danielh121220-cmd/N.A.V.I./docs/CONFIGURACION_WHATSAPP_Y_EMAIL.md

# Avisos a representantes: correo, SMS, WhatsApp y Telegram

Por defecto N.A.V.I avisa solo cuando hay **atraso** o **ausencia** (se cambia en **Ajustes → Avisos a representantes**). Todo se configura desde la app, en **Ajustes → Canales**, sin tocar archivos.

| Canal | Cómo llega | Qué necesitas |
| --- | --- | --- |
| Correo | Automático, con diseño, foto del estudiante y copia al DECE | Una cuenta de Gmail con contraseña de aplicación |
| SMS | Automático, como mensaje de texto normal, aunque el celular del representante no tenga internet | Un celular Android con chip y la app N.A.V.I abierta |
| WhatsApp un toque | La app prepara el mensaje y tú tocas "Enviar" | Nada, funciona desde hoy |
| WhatsApp con Twilio | Automático. Con la cuenta gratis sale dentro de una plantilla de Twilio en inglés; con cuenta pagada, el aviso completo | Cuenta de Twilio (gratis para probar) |
| WhatsApp con Meta | Sale solo desde el número del colegio | Cuenta de Meta Business y una plantilla aprobada |
| Telegram | Automático, gratis y con el texto completo | Un bot de @BotFather (se pega en la app) |

## Correo

1. En la cuenta de Google que enviará los correos activa la **verificación en 2 pasos**.
2. Entra a https://myaccount.google.com/apppasswords, crea una contraseña llamada `NAVI` y copia las 16 letras.
3. En la app: **Ajustes → Canales → Correo**, elige **Gmail**, escribe el correo y pega la contraseña. Toca **Guardar**: N.A.V.I comprueba la conexión al instante y te dice si algo está mal.
4. En **Probar** escribe tu correo y toca **Probar**. Te llega un aviso de ejemplo igual al que verá el representante.

Si el colegio tiene correo propio (`@colegio.edu.ec`), elige **Otro** y pon el servidor SMTP y el puerto que te dé el técnico. Outlook también funciona, pero Microsoft a veces bloquea el envío desde programas: si falla, usa Gmail.

### Copia a la institución

En la misma pantalla, en **Institución**:

- **Correo DECE**: inspección, DECE o el tutor. Puedes poner varios separados por coma.
- **Con copia**: *Ausencias y emergencias* (recomendado), *Todos los avisos* o *Nunca*.
- **Teléfono**: aparece en los avisos urgentes para que el representante llame.
- **Firma**: por ejemplo *Inspección General*.

Cuando un representante responde un correo, la respuesta llega al correo del DECE, no a la cuenta que envía.

### Varios correos por estudiante

En la ficha del estudiante, el campo **Correo** acepta dos correos separados por coma (por ejemplo el del papá y el de la mamá). Los dos reciben el aviso.

## SMS (mensaje de texto al número del representante)

Los SMS salen de un **celular Android con chip** que tenga la app N.A.V.I abierta: puede ser el del docente o uno del colegio. Cada SMS usa el saldo o el plan de ese chip.

1. En la PC: **Ajustes → Canales → SMS al celular** y activa **Enviar avisos por SMS** (solo el administrador).
2. En el celular que enviará los SMS: abre la app de Android, entra con tu cuenta y ve a **Ajustes → SMS al celular**. Activa **Enviar los SMS desde este celular** y acepta el permiso de SMS.
3. En **Probar**, escribe tu número y toca **Probar**: te llega un SMS de ejemplo.
4. En **Ajustes → Avisos a representantes** elige qué avisar: atrasos, ausencias o **cada llegada**.

El mensaje dice, por ejemplo: *«N.A.V.I · Colegio: Daniel Heredia ingresó a clases a las 07:02.»*

- Si el celular que envía está apagado o sin internet, los SMS quedan **esperando** y salen solos apenas vuelve (hasta 6 horas después).
- En **Inicio → Avisos** cada SMS aparece como *Esperando celular*, *Enviando*, *Enviado* o *Falló* (con el motivo: sin señal, sin saldo, modo avión).
- Deja la app abierta o en segundo plano. Si Android la cierra para ahorrar batería, en los ajustes del celular quita la optimización de batería para N.A.V.I.
- En la versión de demostración los SMS no se envían, para no escribir a números inventados.

## WhatsApp

### Un toque (sin configurar nada)

Cada aviso aparece en **Inicio → Avisos** con un botón verde **Enviar**. Al tocarlo se abre WhatsApp con el mensaje ya escrito; solo presionas enviar y vuelves. Si hay varios, toca **N por enviar** arriba de la lista para mandarlos uno tras otro. Cada uno queda marcado como enviado.

Con **También en lo urgente** activado, las ausencias y emergencias se preparan por WhatsApp aunque el correo haya llegado, porque es lo que más leen los padres.

El celular se puede escribir como `0991234567`, `991234567` o `+593 99 123 4567`. Si está mal escrito, la app no te deja guardarlo.

### Automático con Twilio

1. Crea una cuenta gratis en https://www.twilio.com/try-twilio y copia el **Account SID** y el **Auth Token** de la consola.
2. En **Try it out → Send a WhatsApp message** elige el celular que recibirá los avisos y, desde ese WhatsApp, envía `join twilio-trial` al **+1 737 250 8034**.
3. En **Ajustes → Canales → WhatsApp** elige **Twilio**, pega el SID y el token, deja **Plantilla** vacía y toca **Probar**.

Con la cuenta gratis, Twilio no deja mandar texto propio: N.A.V.I lo detecta sola y envía el aviso dentro de la plantilla gratuita de Twilio, por ejemplo *Reminder: Appt N.A.V.I: Daniel Heredia ingresó con atraso, 07:14…*. La cuenta gratis permite un solo celular a la vez. Con una cuenta pagada y el número del sandbox (`+14155238886`) llega el aviso completo en español, siempre que el representante haya escrito al número en las últimas 24 horas.

El Auth Token es como una contraseña: se guarda solo en la PC del servidor, nunca en GitHub, y no se comparte en capturas ni chats.

### Automático (API oficial de Meta)

WhatsApp no permite que un programa escriba solo a cualquier número sin su API oficial. Para activarla:

1. Entra a https://developers.facebook.com/apps, crea una app de tipo **Empresa** y agrega **WhatsApp**.
2. Copia el **Phone number ID** y crea un **token permanente** (usuario del sistema en Meta Business).
3. Crea una plantilla de categoría **Utilidad** llamada `navi_aviso` con este texto:
   ```
   Hola {{1}}, {{2}}
   ```
4. Cuando Meta la apruebe, en **Ajustes → Canales → WhatsApp** elige **Automático**, pega los datos, guarda y usa **Probar**.

Si el envío automático falla (token vencido, número fuera de la lista de prueba), el aviso no se pierde: queda como enlace de un toque y la app te explica el motivo.

## Mensajes escritos por el docente

En **Estudiantes → (estudiante) → Enviar mensaje al representante** puedes escribir un mensaje propio o usar una plantilla: citación a reunión, atrasos frecuentes, recordatorio o felicitación. Eliges por dónde enviarlo y ves la vista previa antes.

## Si un aviso falla

Toca el aviso en **Inicio → Avisos** para ver el mensaje completo, a quién se envió y el motivo del error en palabras simples. Los correos fallidos se pueden **reintentar** desde ahí. Si el servidor de correo no responde, N.A.V.I reintenta solo dos veces antes de marcarlo como fallido.

## Telegram

1. En Telegram habla con **@BotFather**, escribe `/newbot`, ponle un nombre (por ejemplo **N.A.V.I Avisos**) y un usuario que termine en `bot`.
2. Copia el token que te da y pégalo en **Ajustes → Canales → Telegram**. Toca **Probar**: debe decir *Conectado con @tu_bot*. No hace falta reiniciar.
3. En **Estudiantes → (estudiante) → Copiar enlace de Telegram** obtienes un enlace único para ese representante. Cuando lo abra y toque **Iniciar**, queda vinculado.

## Configuración por archivo (opcional)

Si prefieres, el correo también se puede poner en `backend/.env` con `SMTP_USER` y `SMTP_PASS`, y Telegram con `TELEGRAM_BOT_TOKEN`. Lo que configures en la app tiene prioridad.
