danielh121220-cmd/N.A.V.I./docs/reporte/img/mensaje.jpg

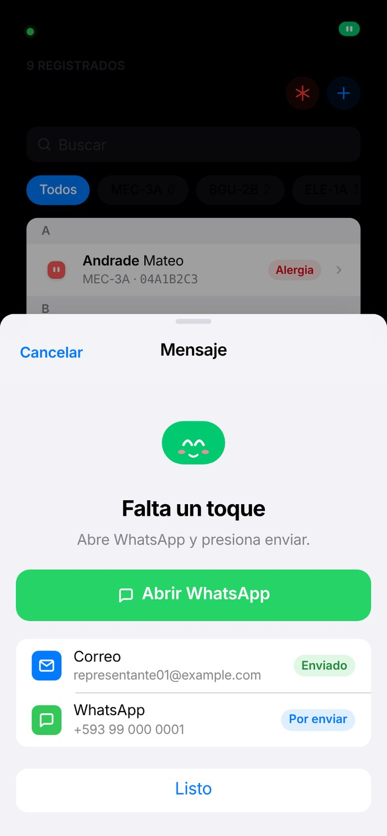
docs/reporte/img/mensaje.jpg
