danielh121220-cmd/N.A.V.I./hardware/cad/vistas/camara.png

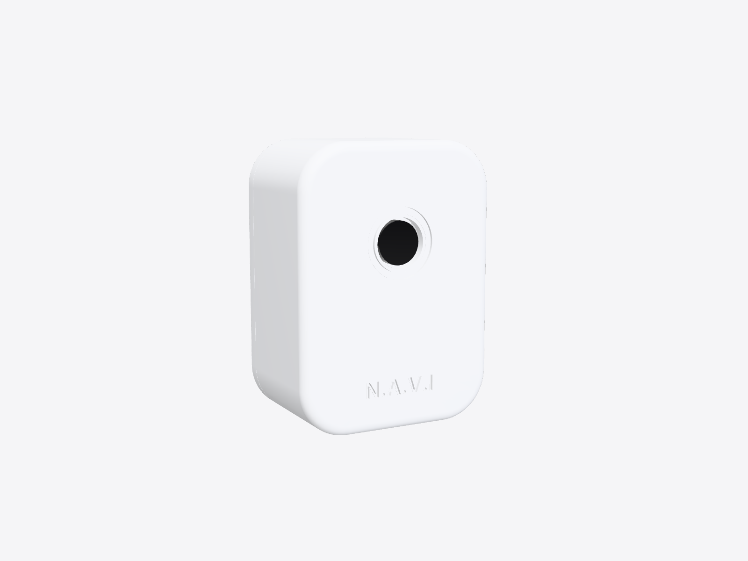
hardware/cad/vistas/camara.png
