danielh121220-cmd/N.A.V.I./hardware/cad/vistas/exhibidor.png

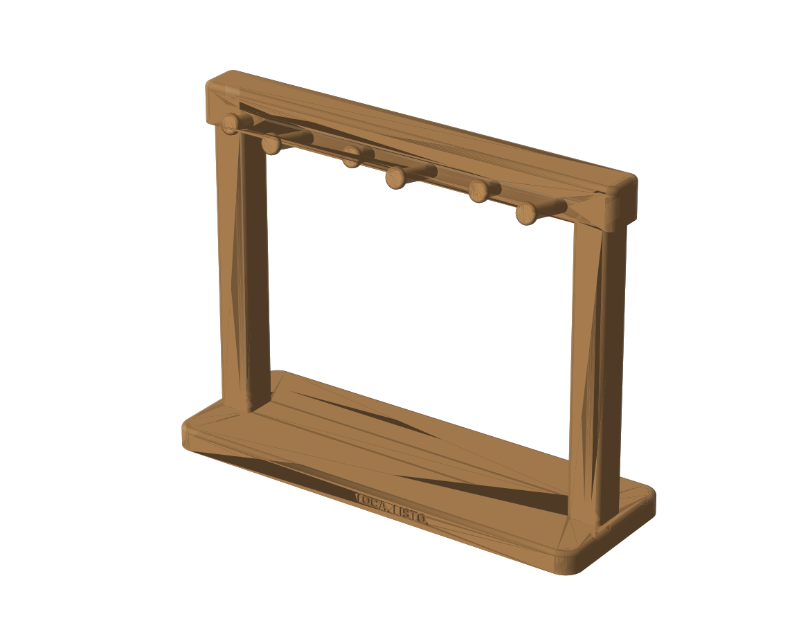
hardware/cad/vistas/exhibidor.png
