danielh121220-cmd/N.A.V.I./hardware/cad/vistas/lector_atras.png

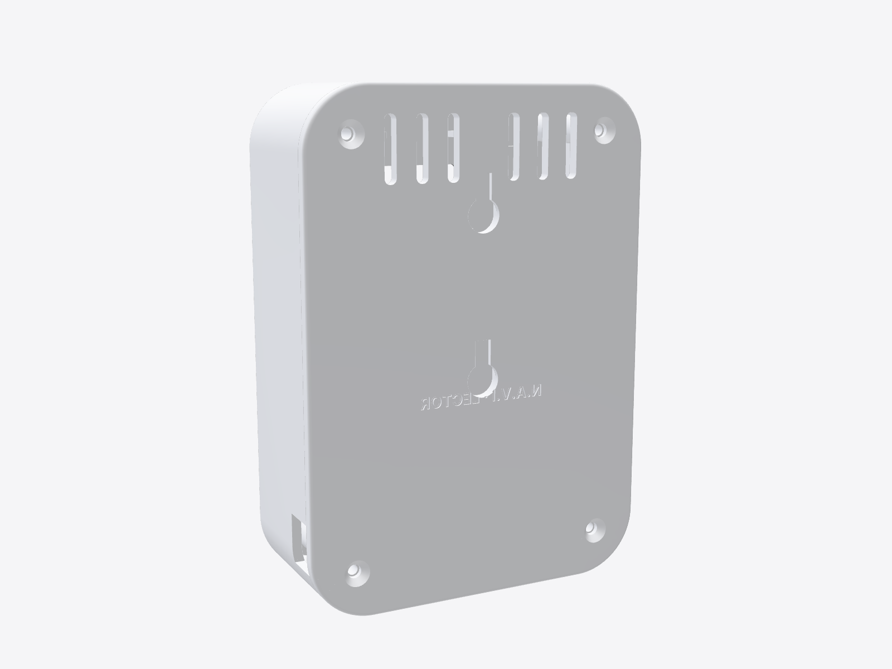
hardware/cad/vistas/lector_atras.png
