danielh121220-cmd/N.A.V.I./hardware/cad/vistas/lector_explosionado.png

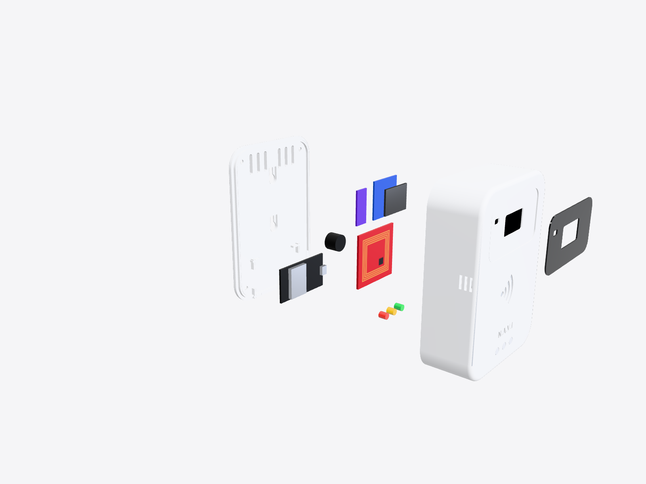
hardware/cad/vistas/lector_explosionado.png
