danielh121220-cmd/N.A.V.I./hardware/cad/vistas/lector_frente.png

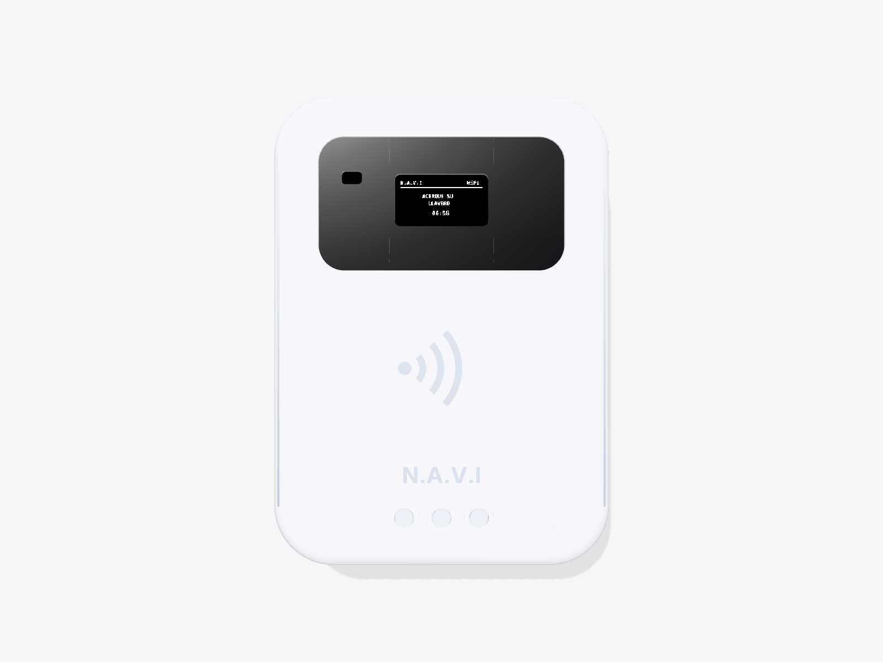
hardware/cad/vistas/lector_frente.png
