danielh121220-cmd/N.A.V.I./hardware/cad/vistas/llavero_atras.png

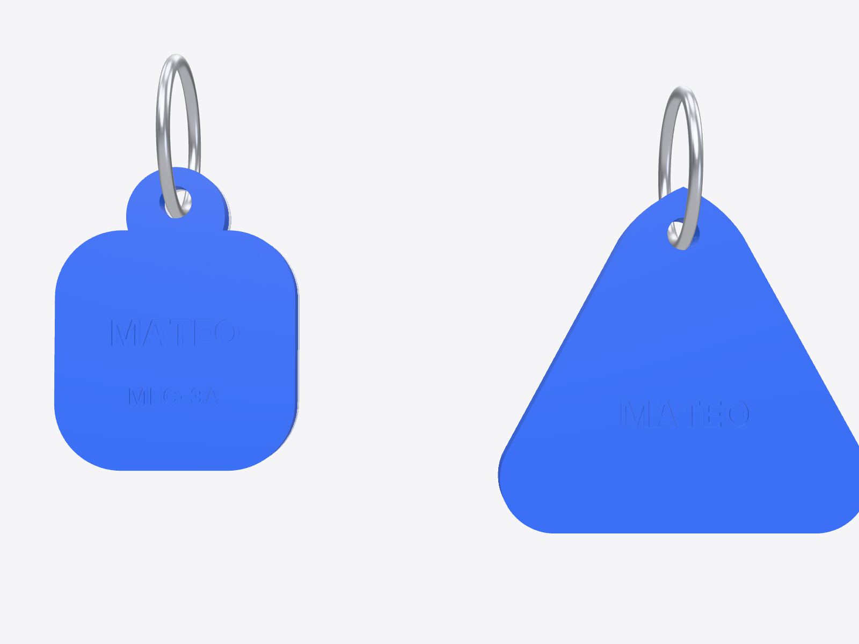
hardware/cad/vistas/llavero_atras.png
