danielh121220-cmd/N.A.V.I./hardware/cad/vistas/llavero_partes.png

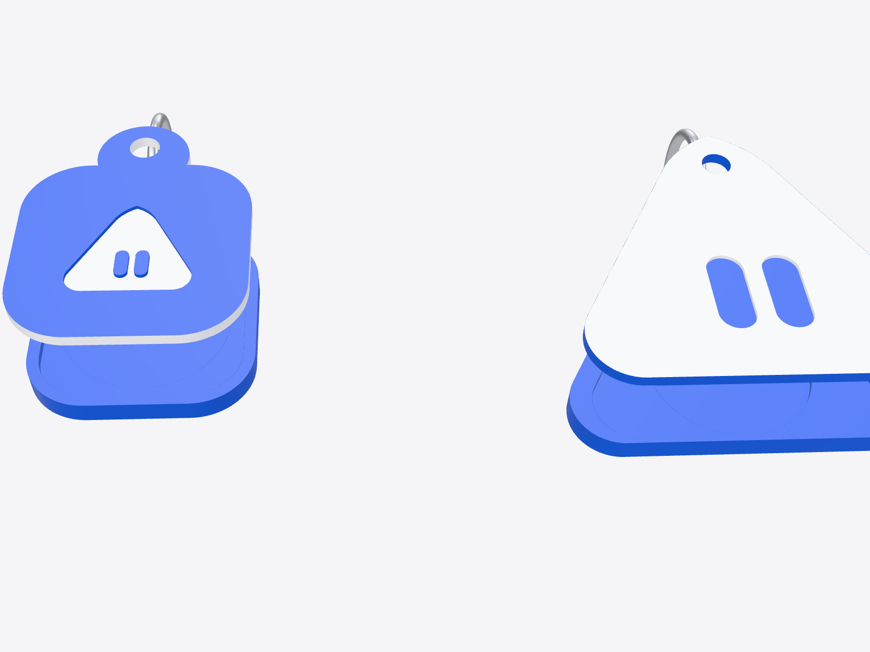
hardware/cad/vistas/llavero_partes.png
