danielh121220-cmd/N.A.V.I./tools/video/assets/desk_inicio.png

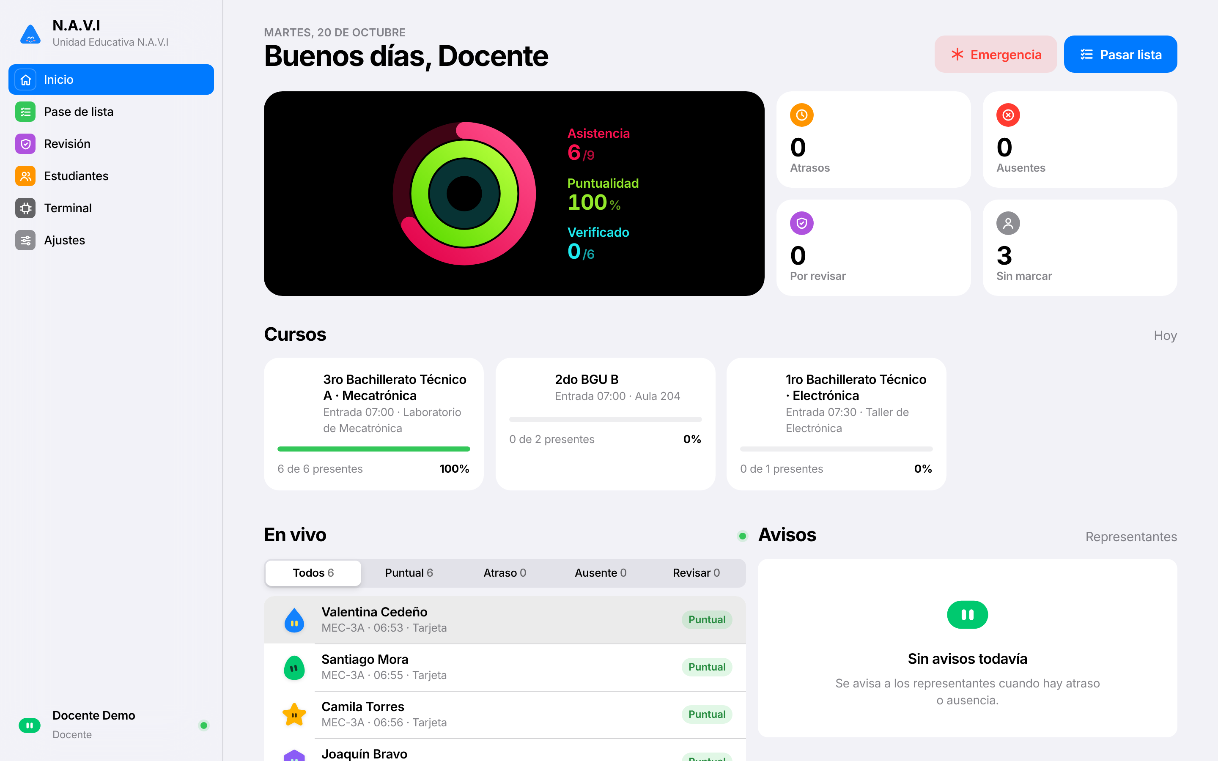
tools/video/assets/desk_inicio.png
