danielh121220-cmd/N.A.V.I./tools/video/assets/ph_born.png

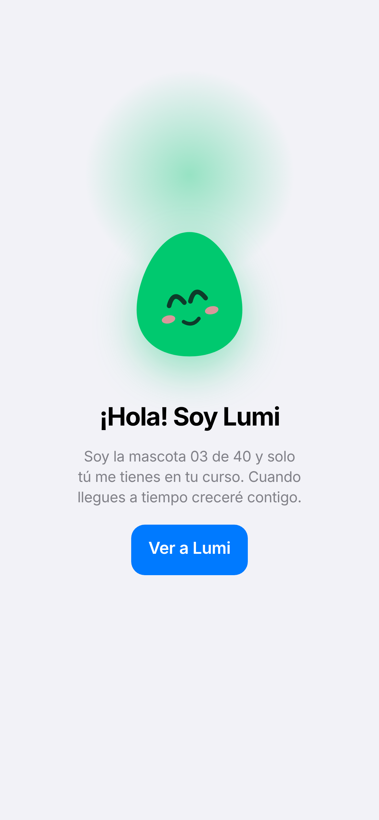
tools/video/assets/ph_born.png
