danielh121220-cmd/N.A.V.I./tools/video/assets/ph_egg.png

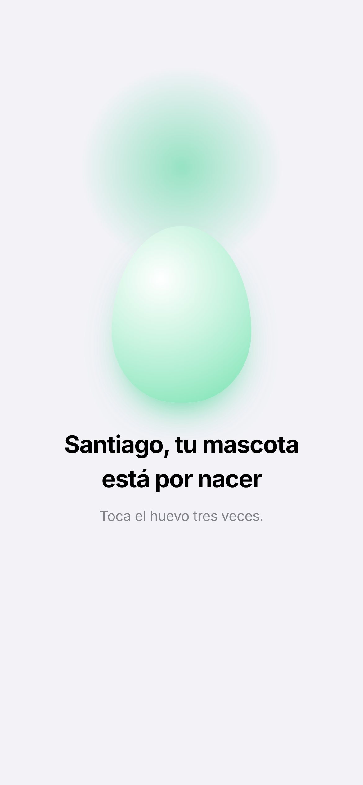
tools/video/assets/ph_egg.png
