danielh121220-cmd/N.A.V.I./tools/video/assets/ph_ficha.png

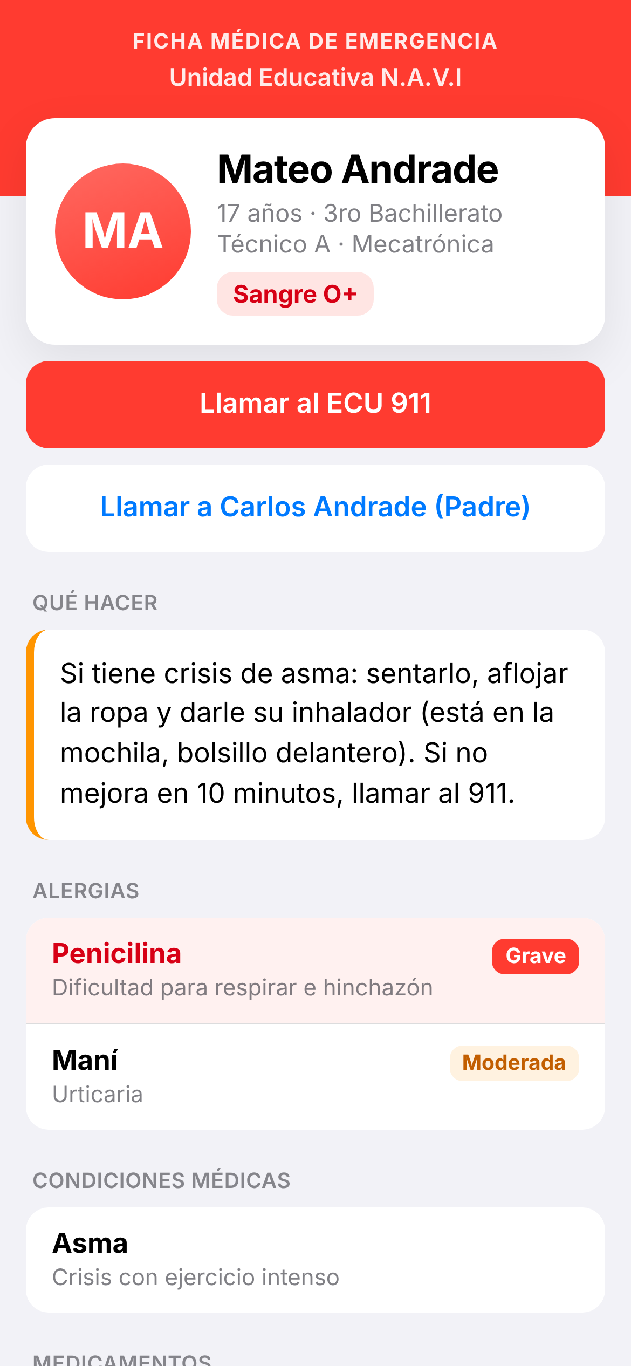
tools/video/assets/ph_ficha.png
