danielh121220-cmd/N.A.V.I./tools/video/assets/ph_gone.png

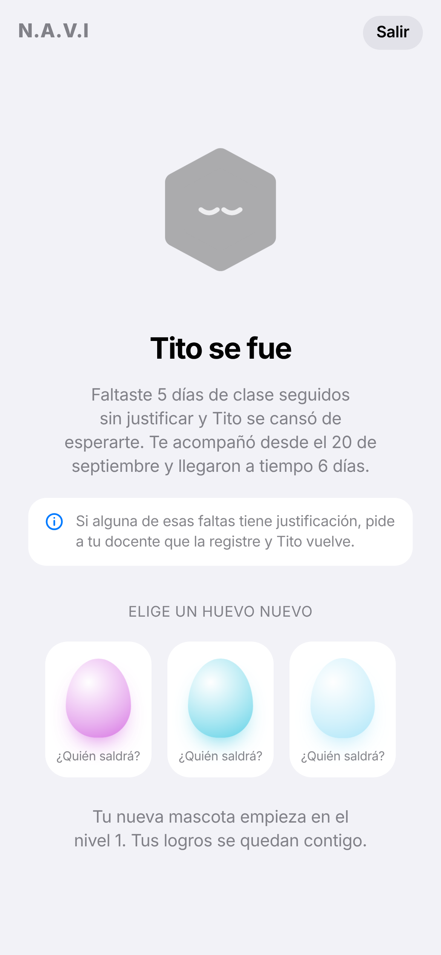
tools/video/assets/ph_gone.png
