danielh121220-cmd/N.A.V.I./tools/video/assets/ph_portal.png

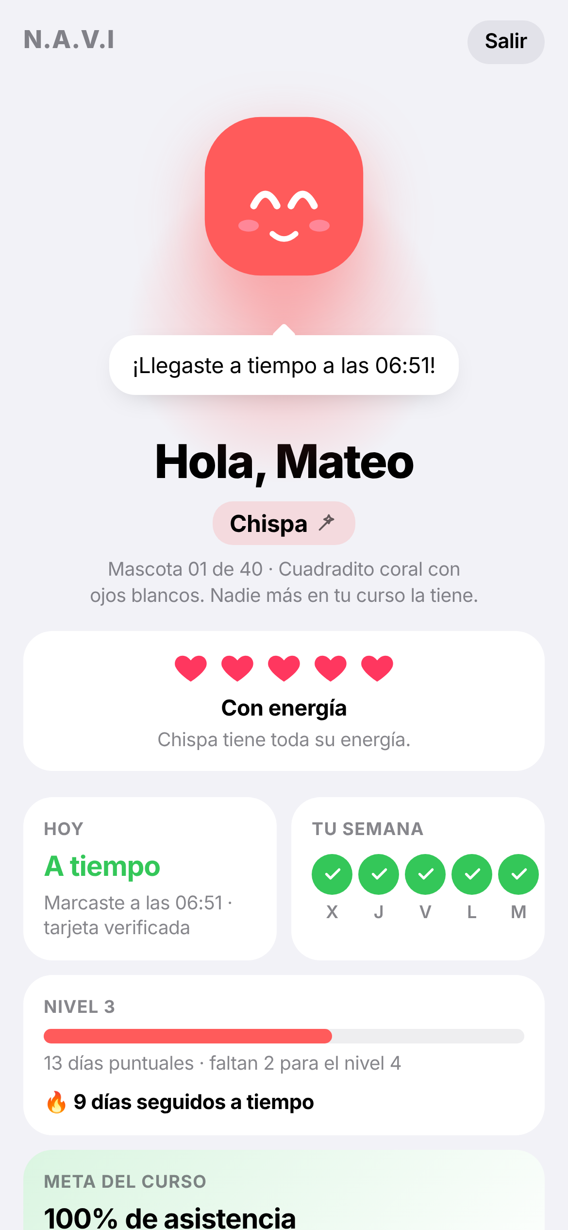
tools/video/assets/ph_portal.png
