danielh121220-cmd/N.A.V.I./tools/video/assets/ph_sick.png

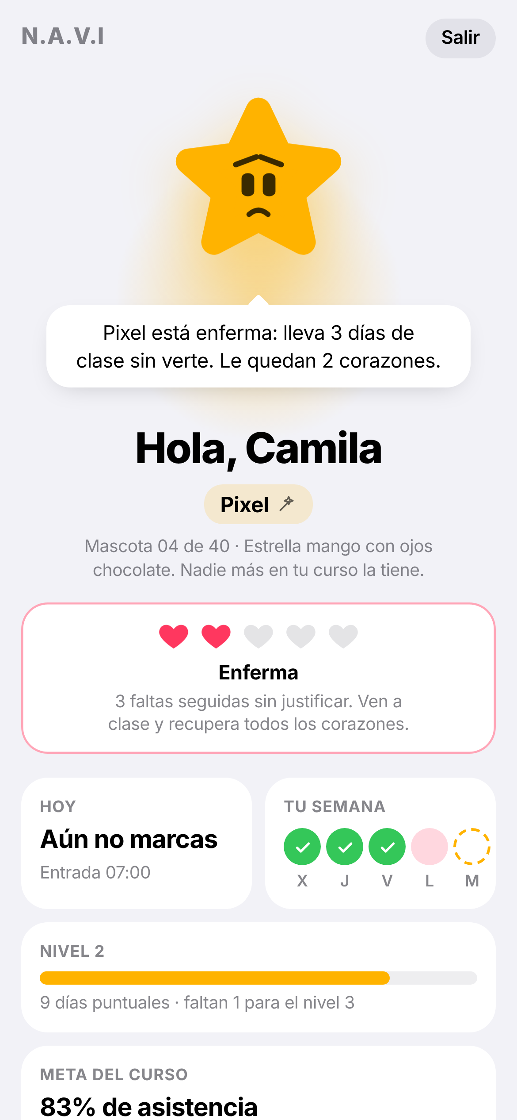
tools/video/assets/ph_sick.png
