danielh121220-cmd/N.A.V.I./tools/video/assets/ph_tour2.png

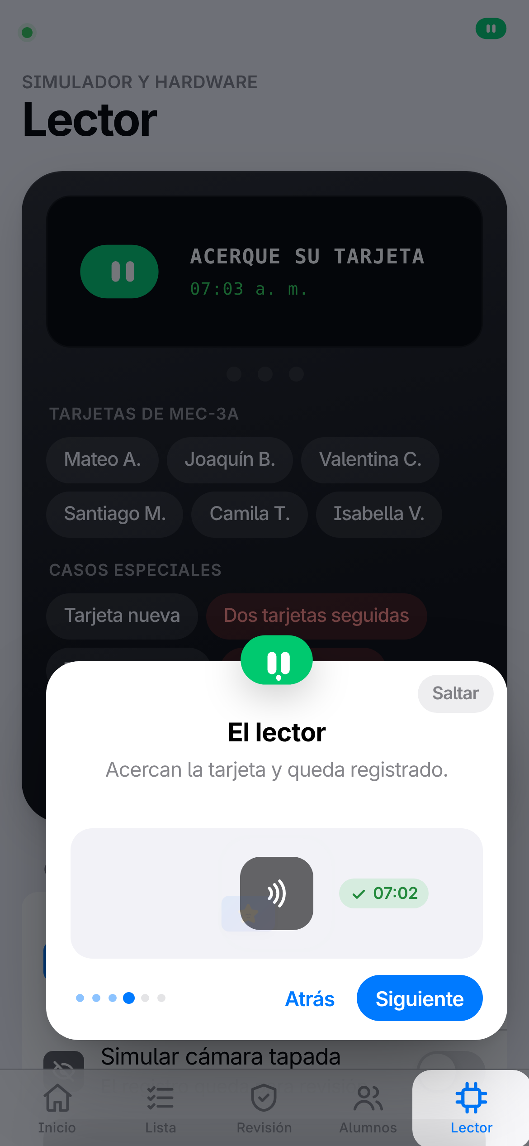
tools/video/assets/ph_tour2.png
