danielh121220-cmd/N.A.V.I./hardware/cad/salida/exhibidor_ensamblado_vista.step

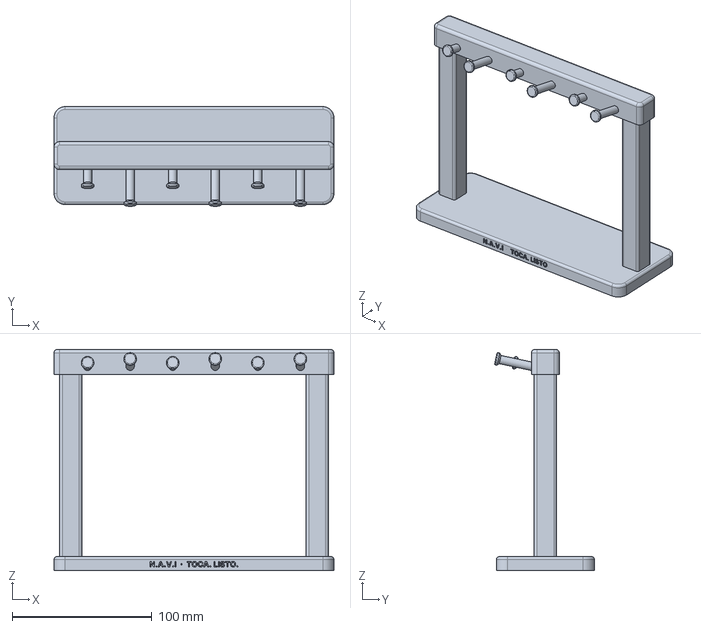
[picture p87: CAD file, 2026-11-06]
hardware/cad/salida/exhibidor_ensamblado_vista.step
200.0 x 71.2 x 158.0 mm
