danielh121220-cmd/N.A.V.I./hardware/cad/salida/exhibidor_base.step

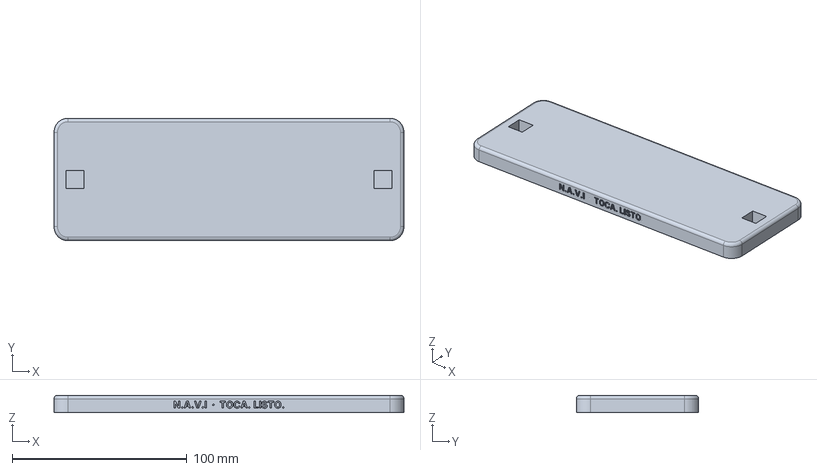
[picture p88: CAD file, 2026-11-06]
hardware/cad/salida/exhibidor_base.step
200.0 x 70.0 x 10.0 mm
