danielh121220-cmd/N.A.V.I./hardware/cad/salida/exhibidor_barra_ganchos.step

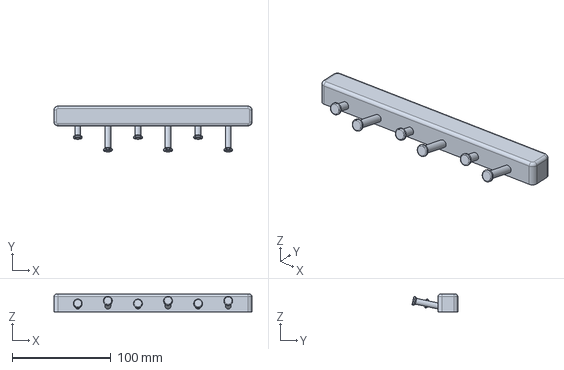
[picture p89: CAD file, 2026-11-06]
hardware/cad/salida/exhibidor_barra_ganchos.step
200.0 x 46.2 x 18.0 mm
