danielh121220-cmd/N.A.V.I./hardware/cad/salida/exhibidor_poste.step

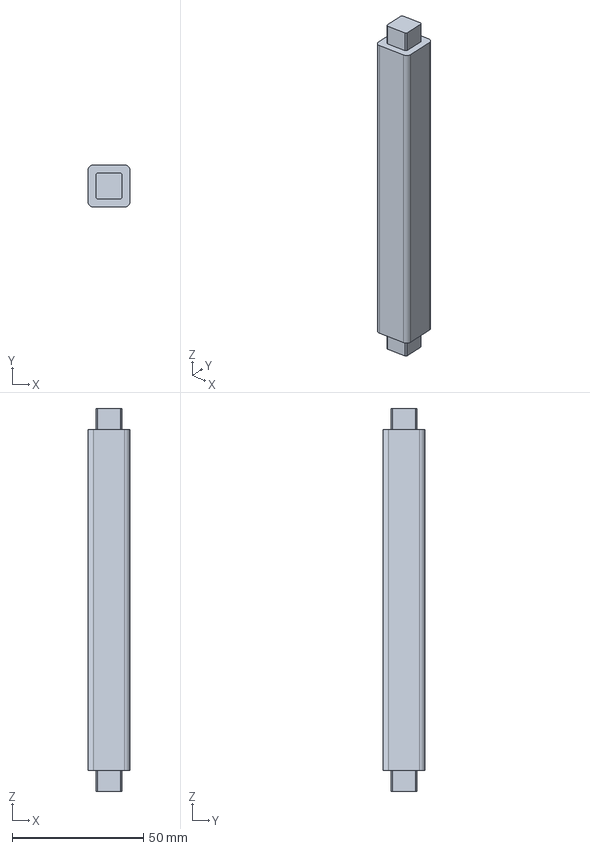
[picture p90: CAD file, 2026-11-06]
hardware/cad/salida/exhibidor_poste.step
16.0 x 16.0 x 146.0 mm
