danielh121220-cmd/N.A.V.I./hardware/cad/salida/soporte_cuna.step

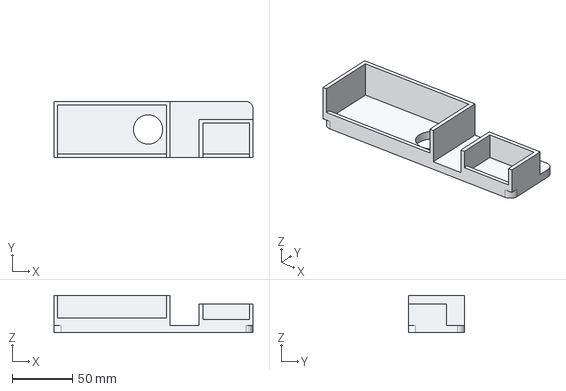
[picture p91: CAD file, 2026-11-04]
hardware/cad/salida/soporte_cuna.step
165.8 x 46.8 x 31.0 mm
