danielh121220-cmd/N.A.V.I./hardware/cad/salida/llavero_kuro_una_pieza.step

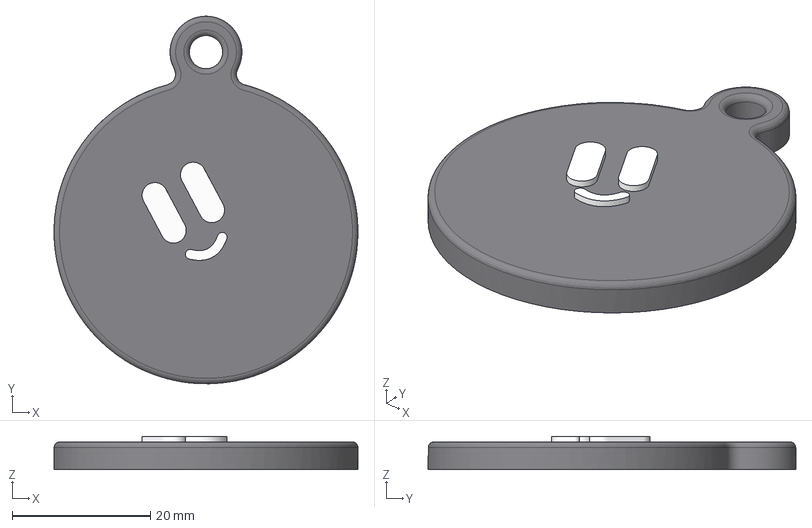
[picture p92: CAD file, 2026-11-04]
hardware/cad/salida/llavero_kuro_una_pieza.step
44.0 x 53.2 x 4.80 mm
