danielh121220-cmd/N.A.V.I./hardware/cad/salida/llavero_bean_una_pieza.step

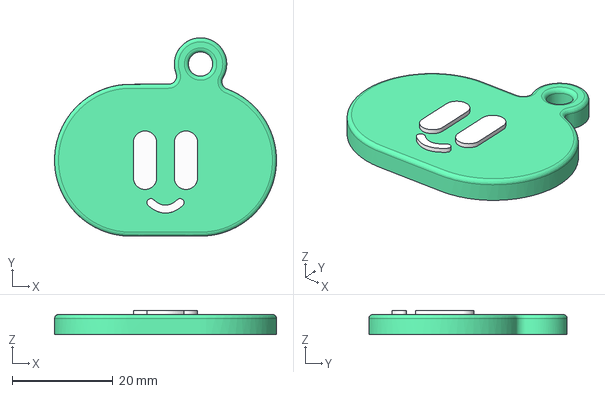
[picture p93: CAD file, 2026-11-04]
hardware/cad/salida/llavero_bean_una_pieza.step
44.0 x 39.3 x 4.80 mm
