danielh121220-cmd/N.A.V.I./hardware/cad/salida/llavero_delta_una_pieza.step

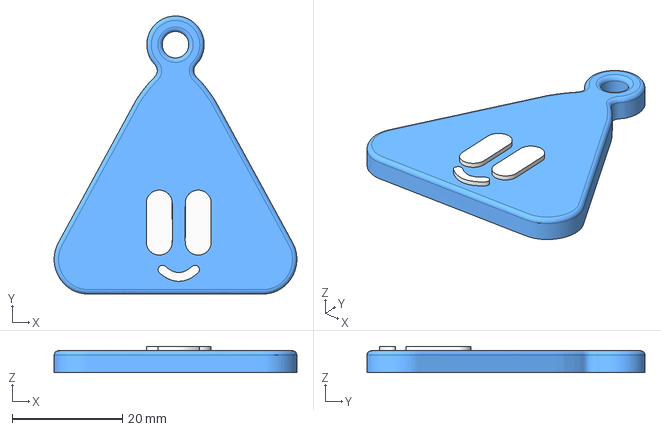
[picture p95: CAD file, 2026-11-04]
hardware/cad/salida/llavero_delta_una_pieza.step
44.0 x 50.4 x 4.80 mm
