danielh121220-cmd/N.A.V.I./hardware/cad/salida/soporte_palo_y_base.step

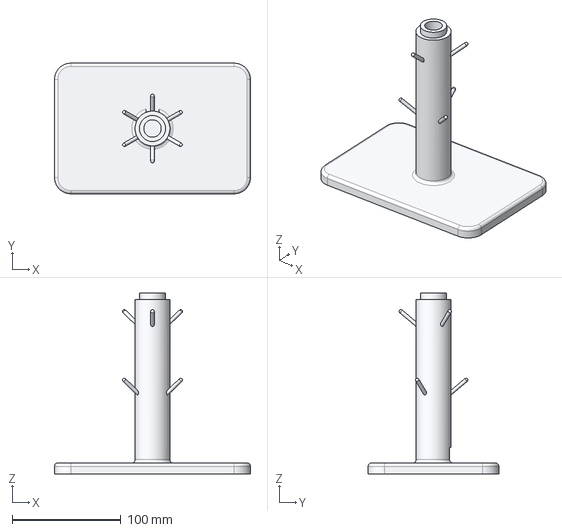
[picture p96: CAD file, 2026-11-04]
hardware/cad/salida/soporte_palo_y_base.step
180.0 x 120.0 x 166.0 mm
