danielh121220-cmd/N.A.V.I./hardware/cad/salida/llavero_bot_base_sin_nombre.step

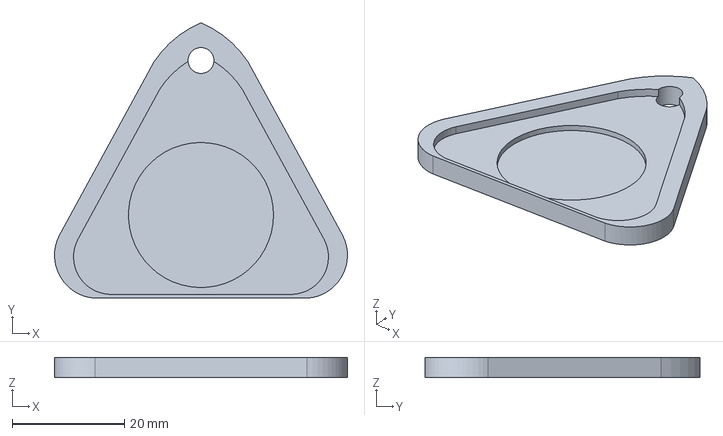
[picture p99: CAD file, 2026-10-21]
hardware/cad/salida/llavero_bot_base_sin_nombre.step
52.1 x 49.0 x 3.60 mm
