danielh121220-cmd/N.A.V.I./hardware/cad/salida/camara_frente.step

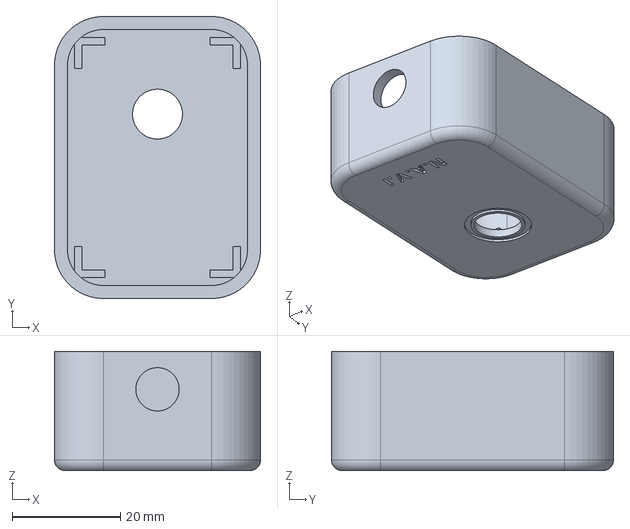
[picture p101: CAD file, 2026-10-21]
hardware/cad/salida/camara_frente.step
38.0 x 52.0 x 22.0 mm
