danielh121220-cmd/N.A.V.I./hardware/cad/salida/lector_tapa.step

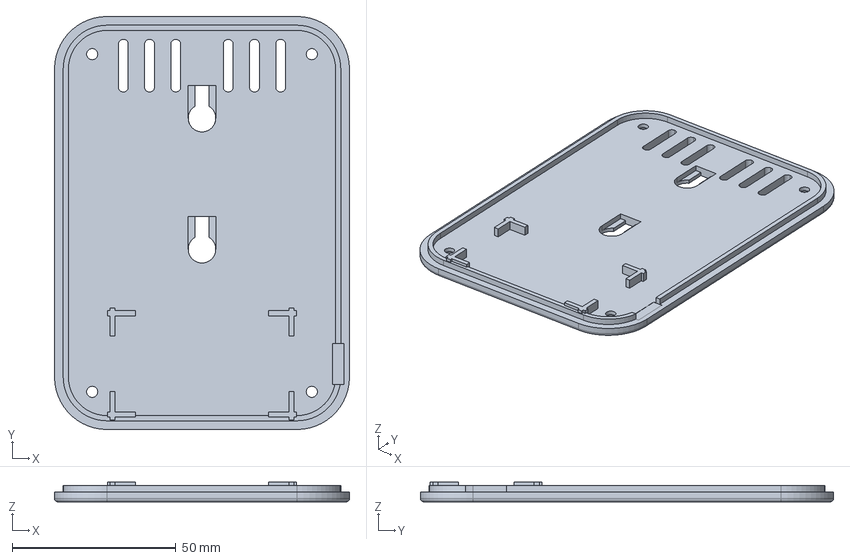
[picture p102: CAD file, 2026-10-21]
hardware/cad/salida/lector_tapa.step
90.0 x 126.0 x 6.00 mm
