danielh121220-cmd/N.A.V.I./hardware/cad/salida/lector_frente.step

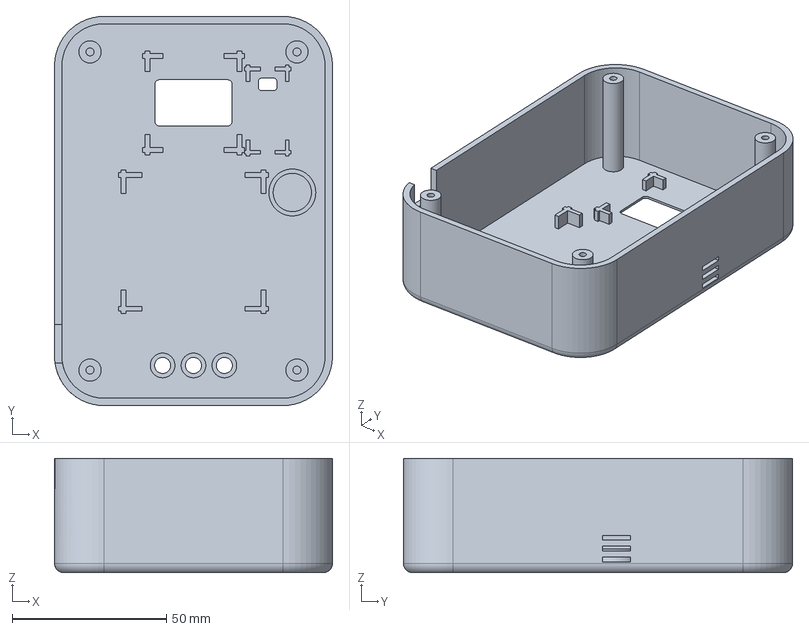
[picture p103: CAD file, 2026-10-21]
hardware/cad/salida/lector_frente.step
90.0 x 126.0 x 37.0 mm
