danielh121220-cmd/N.A.V.I./hardware/cad/salida/llavero_icono_tapa.step

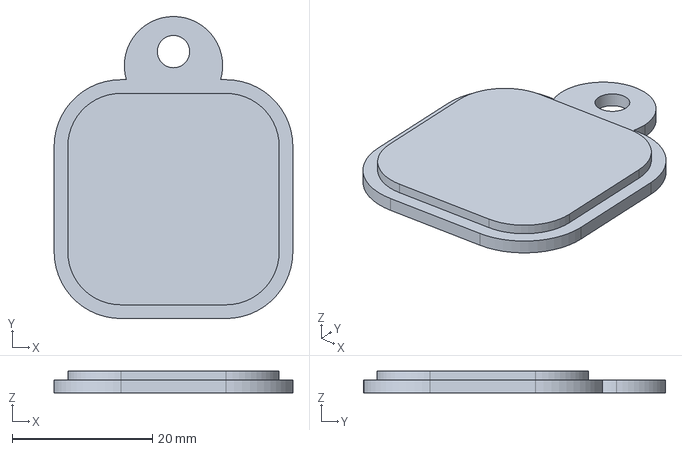
[picture p104: CAD file, 2026-10-21]
hardware/cad/salida/llavero_icono_tapa.step
34.0 x 43.0 x 3.10 mm
