danielh121220-cmd/N.A.V.I./hardware/cad/salida/llavero_icono_base_mateo.step

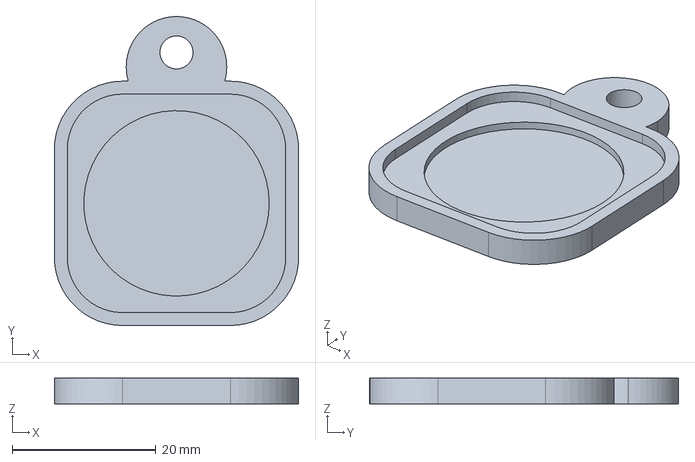
[picture p105: CAD file, 2026-10-21]
hardware/cad/salida/llavero_icono_base_mateo.step
34.0 x 43.0 x 3.60 mm
