danielh121220-cmd/N.A.V.I./hardware/cad/salida/camara_tapa.step

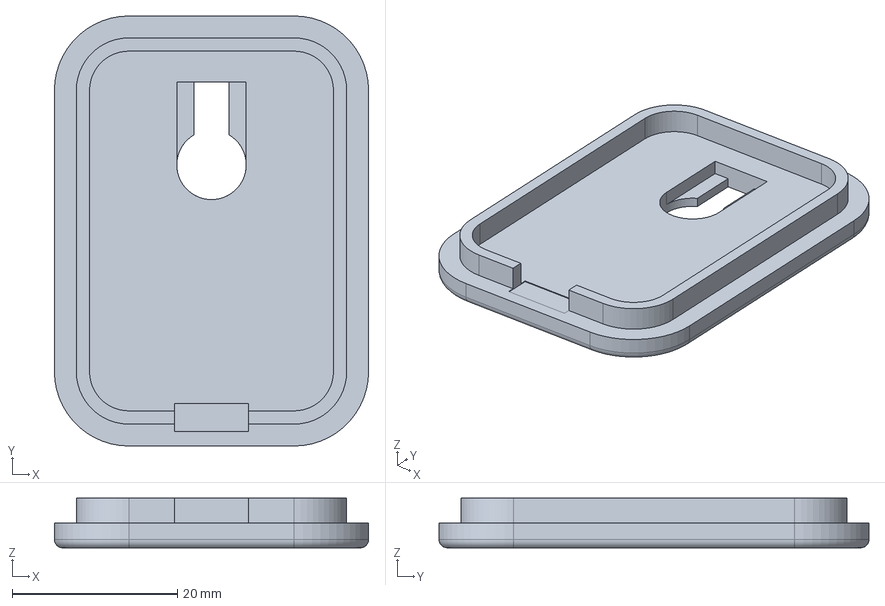
[picture p106: CAD file, 2026-10-21]
hardware/cad/salida/camara_tapa.step
38.0 x 52.0 x 6.00 mm
