danielh121220-cmd/N.A.V.I./hardware/cad/salida/lector_panel_negro.step

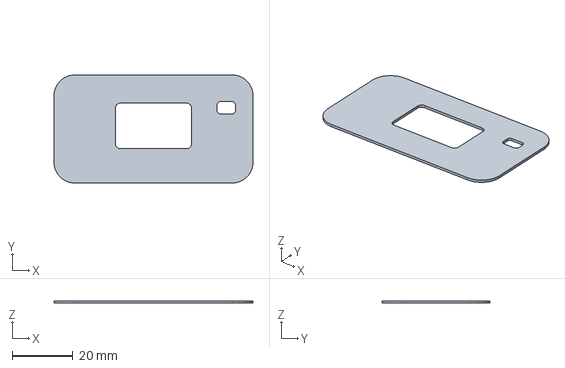
[picture p107: CAD file, 2026-10-21]
hardware/cad/salida/lector_panel_negro.step
65.6 x 35.6 x 0.8 mm
