danielh121220-cmd/N.A.V.I./(list of files, cad)

Other CAD files:
hardware/cad/salida/llavero_bot_base_mateo.step
hardware/cad/salida/camara_frente.stl
hardware/cad/salida/camara_tapa.stl
hardware/cad/salida/exhibidor_barra_ganchos.stl
hardware/cad/salida/exhibidor_base.stl
hardware/cad/salida/exhibidor_poste.stl
hardware/cad/salida/lector_frente.stl
hardware/cad/salida/lector_panel_negro.stl
hardware/cad/salida/lector_tapa.stl
hardware/cad/salida/llavero_bean_una_pieza.stl
hardware/cad/salida/llavero_bloom_una_pieza.stl
hardware/cad/salida/llavero_bot_base_mateo.stl
hardware/cad/salida/llavero_bot_base_sin_nombre.stl
hardware/cad/salida/llavero_bot_tapa.stl
hardware/cad/salida/llavero_delta_una_pieza.stl
hardware/cad/salida/llavero_icono_base_mateo.stl
hardware/cad/salida/llavero_icono_base_sin_nombre.stl
hardware/cad/salida/llavero_icono_tapa.stl
hardware/cad/salida/llavero_kuro_una_pieza.stl
hardware/cad/salida/llavero_nimbo_una_pieza.stl
hardware/cad/salida/llavero_pebble_una_pieza.stl
hardware/cad/salida/soporte_cuna.stl
hardware/cad/salida/soporte_palo_y_base.stl
