danielh121220-cmd/N.A.V.I./tools/video/assets/desk_risk.png

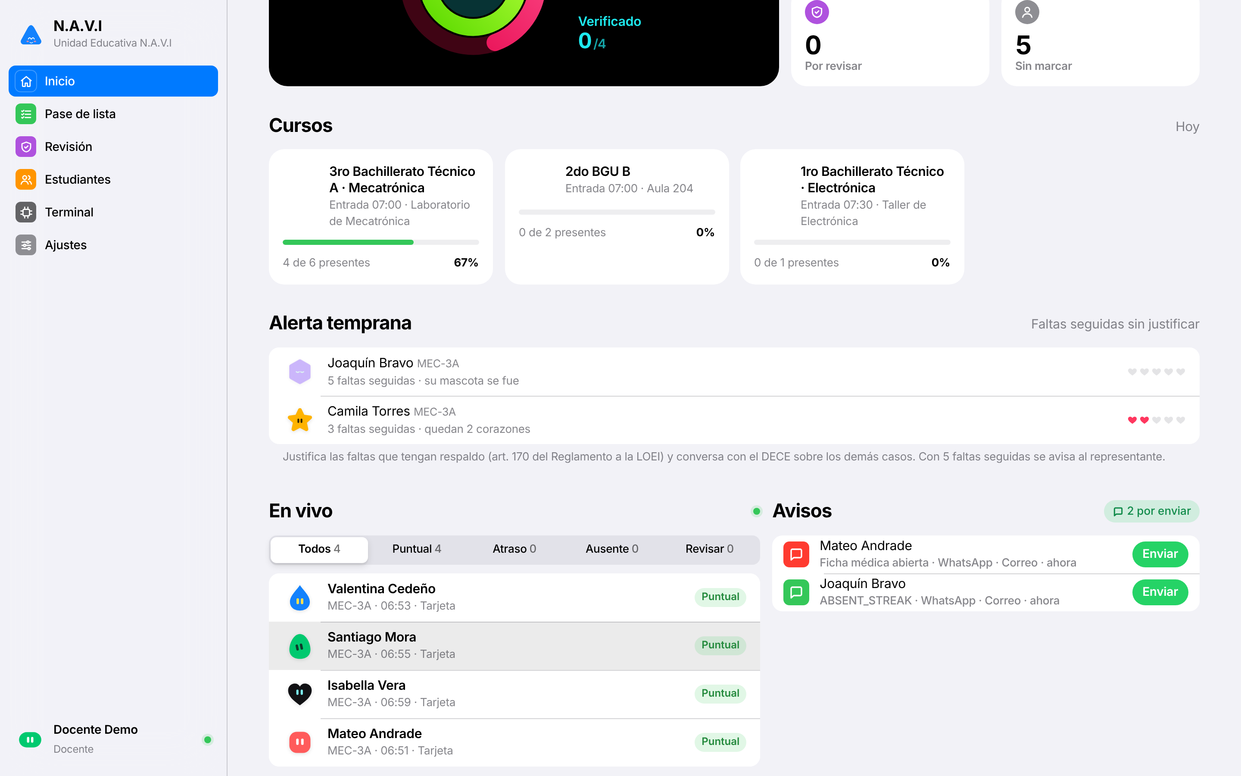
tools/video/assets/desk_risk.png
