danielh121220-cmd/N.A.V.I./docs/Triptico_NAVI.pdf

## CADA ESTUDIANTE TIENE SU MASCOTA

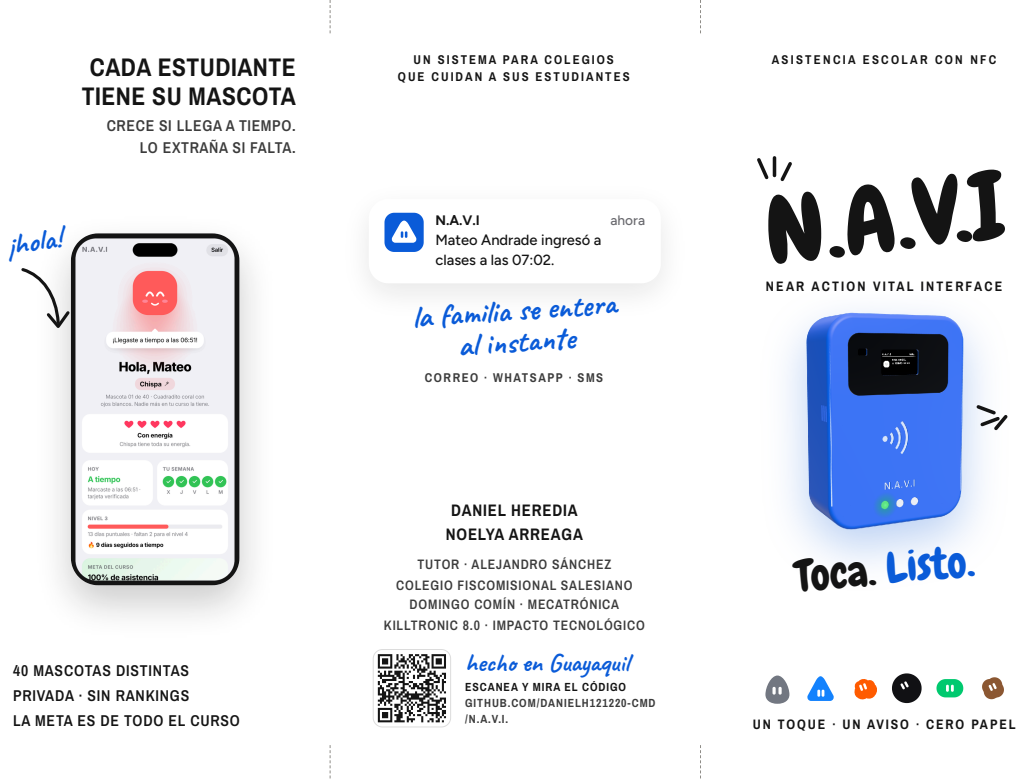
[picture p110: page 1]
U N S I S T EMA PA R A C O L E G I O S Q U E C U I D A N A S U S E S T U D I A N T E S; ahora; DANIEL HEREDIA NOELYA ARREAGA; ¡hola!; al instante; Toca. Listo.

CRECE SI LLEGA A TIEMPO.
LO EXTRAÑA SI FALTA.

Mateo Andrade ingresó a
clases a las 07:02.

la familia se entera

CORREO · WHATSAPP · SMS

TUTOR · ALEJANDRO SÁNCHEZ
COLEGIO FISCOMISIONAL SALESIANO
DOMINGO COMÍN · MECATRÓNICA
KILLTRONIC 8.0 · IMPACTO TECNOLÓGICO
hecho en Guayaquil

40 MASCOTAS DISTINTAS
PRIVADA · SIN RANKINGS
LA META ES DE TODO EL CURSO

ESCANEA Y MIRA EL CÓDIGO
GITHUB.COM/DANIELH121220-CMD

UN TOQUE · UN AV I SO · CERO PAP E L

# LO QUE HACE

# NADIE MARCA

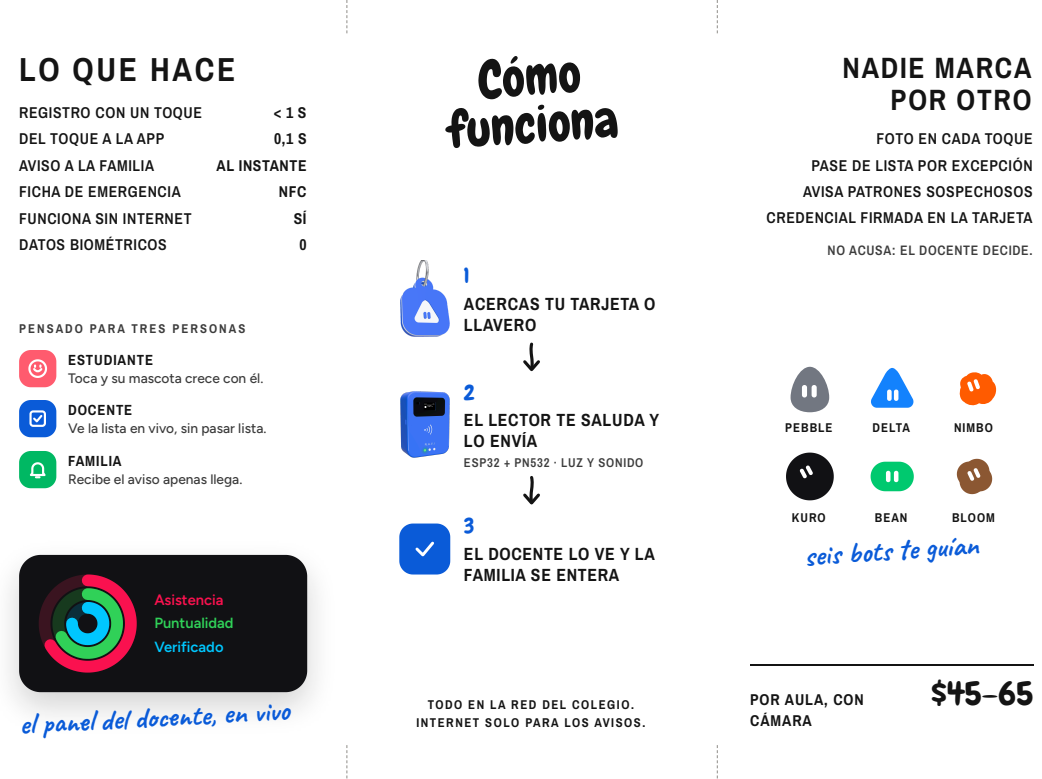
[picture p111: page 2]
REGISTRO CON UN TOQUE; DEL TOQUE A LA APP; AVISO A LA FAMILIA; AL INSTANTE; FICHA DE EMERGENCIA; NFC; FUNCIONA SIN INTERNET; DATOS BIOMÉTRICOS; Asistencia Puntualidad Verificado; ACERCAS TU TARJETA O LLAVERO; POR OTRO; PEBBLE; DELTA; NIMBO; KURO; BEAN; BLOOM; Cómo funciona

FOTO EN CADA TOQUE

PASE DE LISTA POR EXCEPCIÓN
AVISA PATRONES SOSPECHOSOS
CREDENCIAL FIRMADA EN LA TARJETA

NO ACUSA: EL DOCENTE DECIDE.

ESTUDIANTE
Toca y su mascota crece con él.
DOCENTE
Ve la lista en vivo, sin pasar lista.

EL LECTOR TE SALUDA Y
LO ENVÍA
ESP32 + PN532 · LUZ Y SONIDO

FAMILIA
Recibe el aviso apenas llega.

EL DOCENTE LO VE Y LA
FAMILIA SE ENTERA

seis bots te guían

el panel del docente, en vivo

POR AULA, CON
CÁMARA

TODO EN LA RED DEL COLEGIO.
INTERNET SOLO PARA LOS AVISOS.
