danielh121220-cmd/N.A.V.I./(commit log)

2026-10-21 Version 3.4
    [camara_frente.step, camara_frente.stl, camara_tapa.step, camara_tapa.stl, lector_frente.step, lector_frente.stl, lector_panel_negro.step, lector_panel_negro.stl]
2026-10-29 lector-3.8: detecta solo si el PN532 va por UART o I2C
2026-10-29 camara-3.5: fotos en cualquier red (la camara espera el pedido en una conexion abierta)
2026-10-29 camara-3.6 (hotspot de Windows) y presentacion final Killtronic 8.0
2026-11-04 README nuevo con imágenes, N.A.V.I = Near Agent Vital Intelligent, llaveros y soporte
    [llavero_bean_una_pieza.step, llavero_bean_una_pieza.stl, llavero_bloom_una_pieza.step, llavero_bloom_una_pieza.stl, llavero_delta_una_pieza.step, llavero_delta_una_pieza.stl, llavero_kuro_una_pieza.step, llavero_kuro_una_pieza.stl]
2026-11-05 Siglas en la portada del PowerPoint y del tríptico; tríptico para imprimir
2026-11-05 Twilio gratis por defecto y Telegram configurable desde la app
2026-11-05 Actualiza la demostración en un solo archivo
2026-11-06 Exhibidor de llaveros para imprimir en 3D
    [exhibidor_barra_ganchos.step, exhibidor_barra_ganchos.stl, exhibidor_base.step, exhibidor_base.stl, exhibidor_ensamblado_vista.step, exhibidor_poste.step, exhibidor_poste.stl]
2026-11-06 Registra los errores corregidos de Twilio y Telegram
